ktw1525/KiCAD_Libraries/3D/JB-601.step

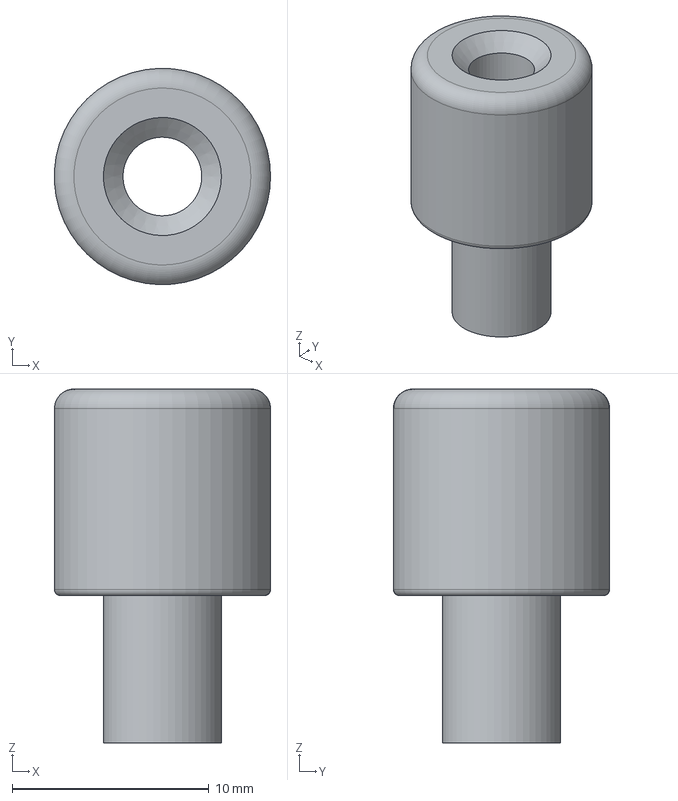
[picture p1: CAD file, 2025-05-28]
3D/JB-601.step
11.0 x 11.0 x 18.0 mm
