ktw1525/KiCAD_Libraries/3D/push button.FCStd

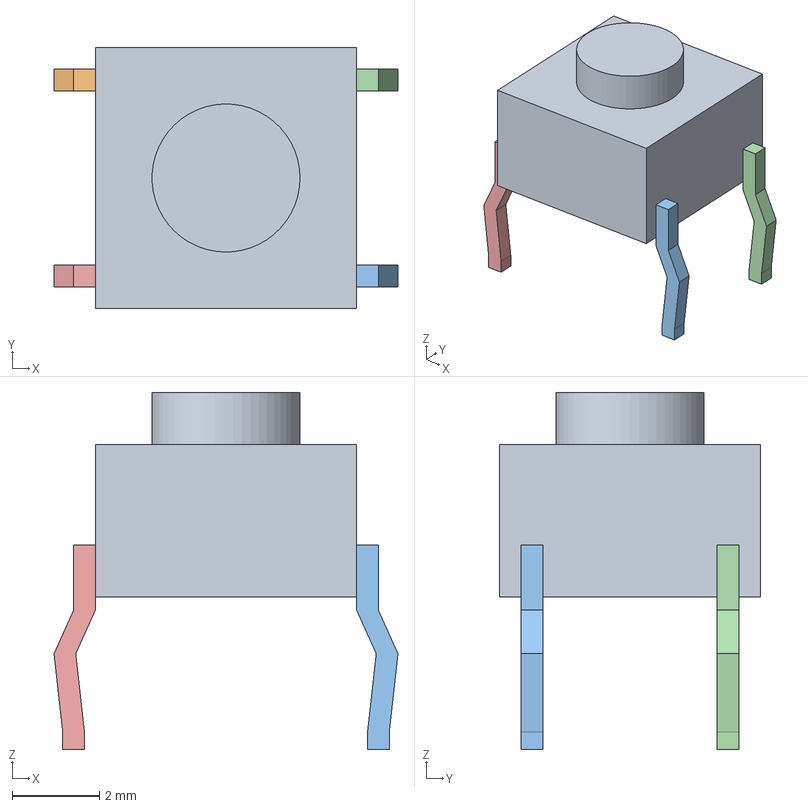
[picture p2: CAD file, 2025-05-28]
3D/push button.FCStd
7.90 x 6.00 x 8.20 mm
몸통
foot
foot (Mirror #3)
foot (Mirror #1)
foot (Mirror #2)
