ktw1525/KiCAD_Libraries/3D/YDSR-4036KM.step

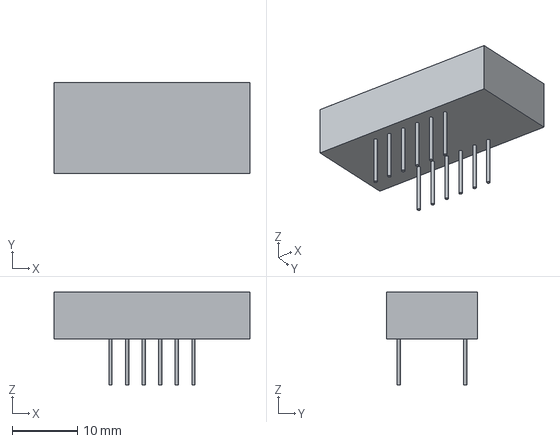
[picture p3: CAD file, 2025-05-28]
3D/YDSR-4036KM.step
30.0 x 14.0 x 14.2 mm
