ktw1525/KiCAD_Libraries/3D/TS-1105-4.3MM.step

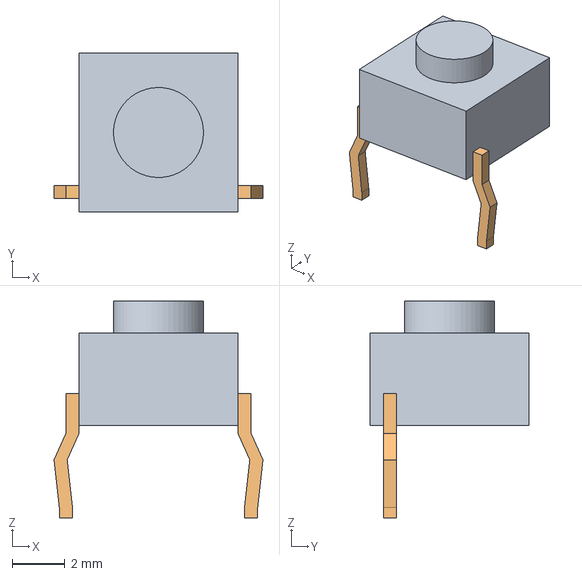
[picture p4: CAD file, 2025-05-28]
3D/TS-1105-4.3MM.step
7.90 x 6.00 x 8.20 mm
