ktw1525/KiCAD_Libraries/3D/br-112.step

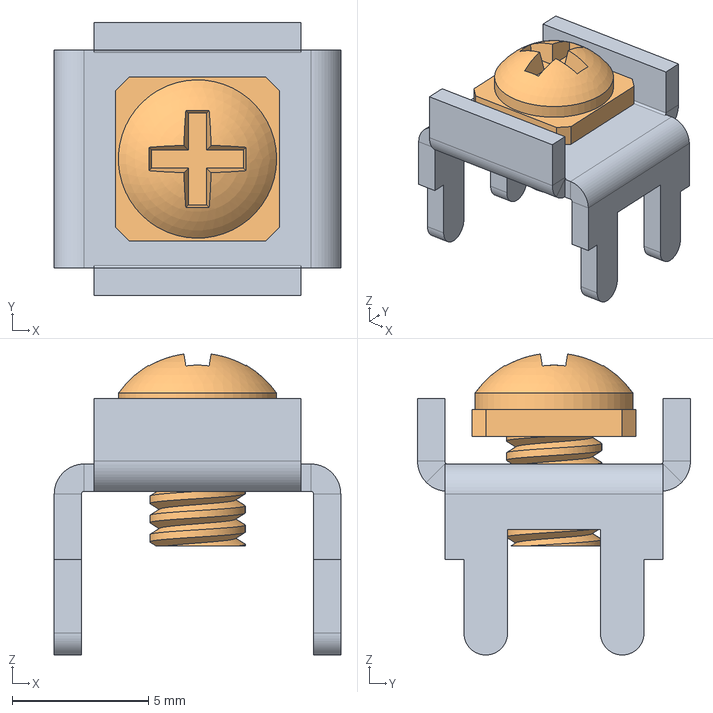
[picture p5: CAD file, 2025-01-15]
3D/br-112.step
10.5 x 10.0 x 11.0 mm
M3.5_SQPAD
