ktw1525/KiCAD_Libraries/3D/br-114.step

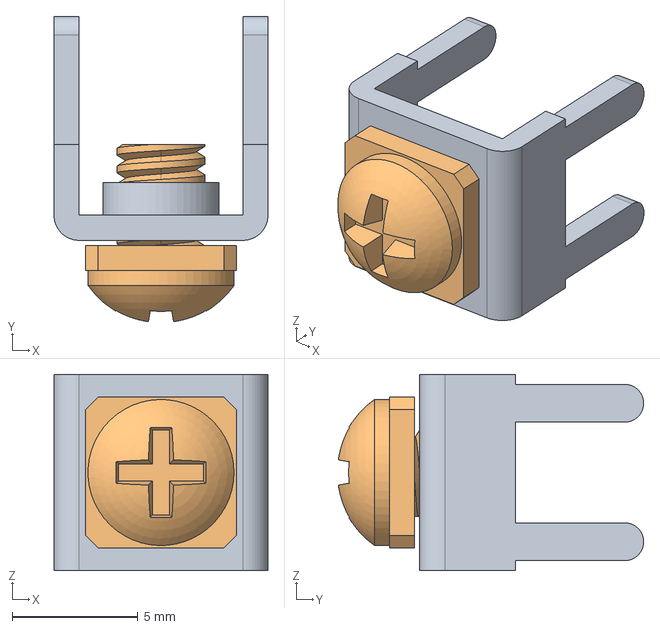
[picture p6: CAD file, 2025-01-15]
3D/br-114.step
8.50 x 12.1 x 7.80 mm
BR-114
M3.5_SQPAD
