ktw1525/KiCAD_Libraries/3D/WM-N502K.step

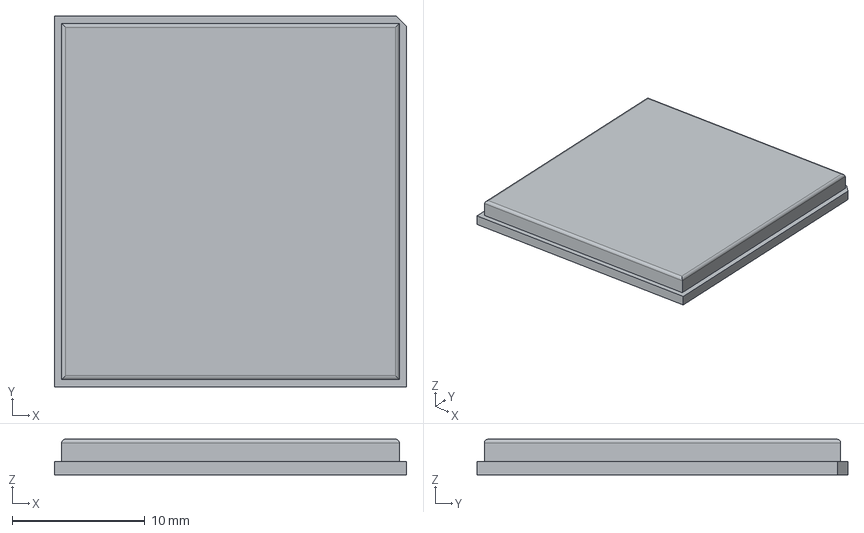
[picture p7: CAD file, 2025-01-07]
3D/WM-N502K.step
26.6 x 28.0 x 2.70 mm
