ktw1525/KiCAD_Libraries/3D/IRM-15-5.stp

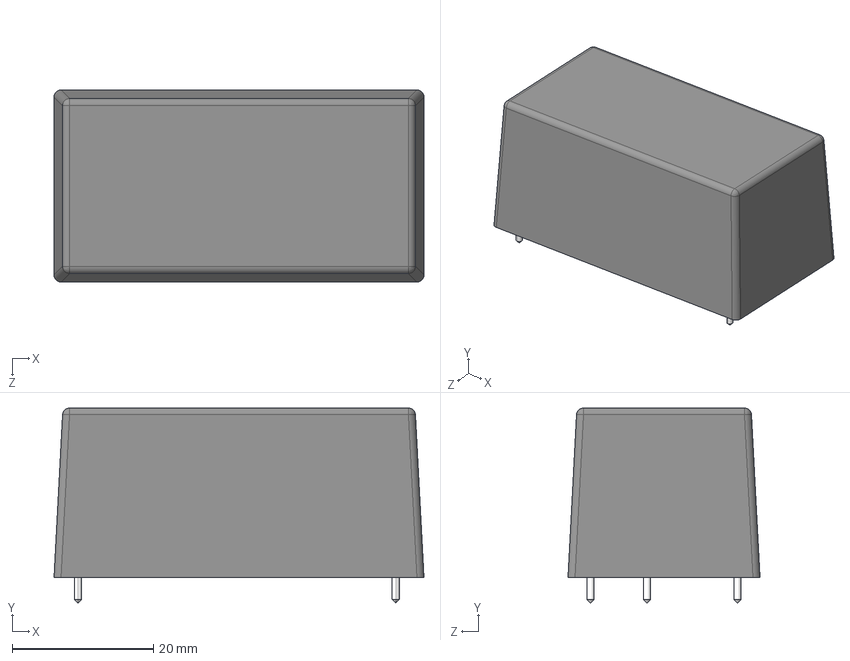
[picture p8: CAD file, 2025-01-02]
3D/IRM-15-5.stp
52.4 x 27.6 x 27.2 mm
