ktw1525/KiCAD_Libraries/3D/7701.stp

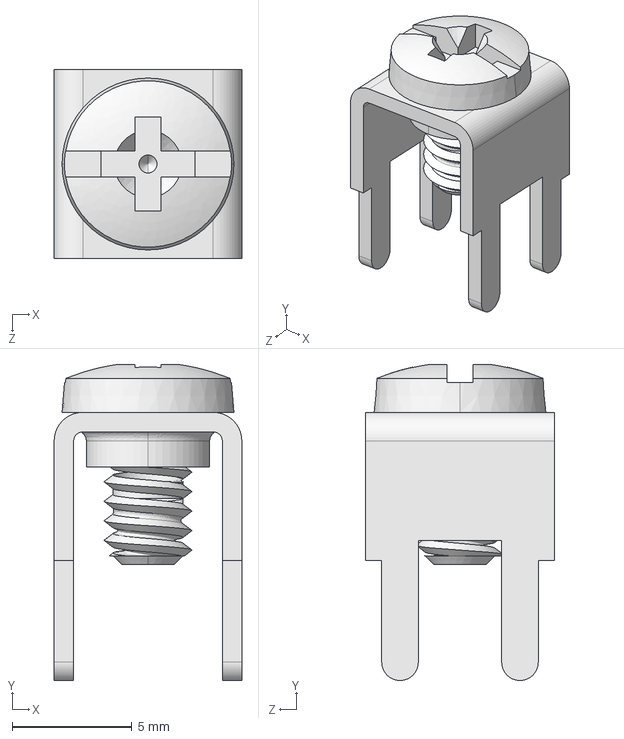
[picture p9: CAD file, 2025-01-02]
3D/7701.stp
7.82 x 13.2 x 7.87 mm
