ktw1525/KiCAD_Libraries/3D/HLK-10M05.stp

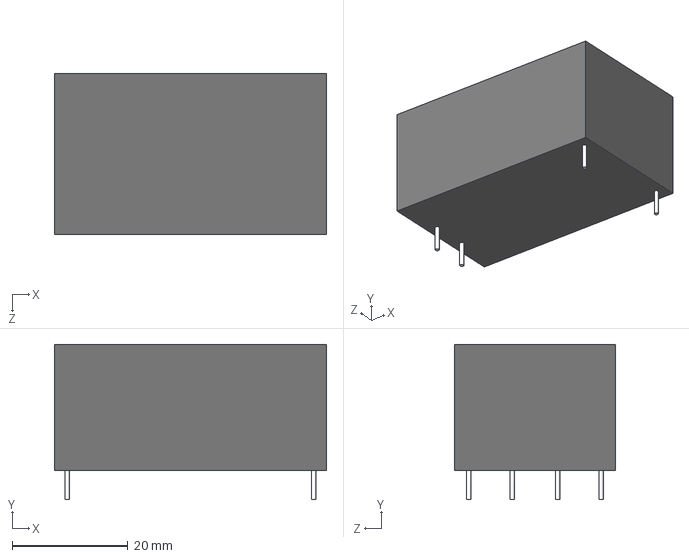
[picture p10: CAD file, 2025-01-02]
3D/HLK-10M05.stp
46.9 x 26.8 x 27.8 mm
