ktw1525/KiCAD_Libraries/3D/BG95-M3.stp

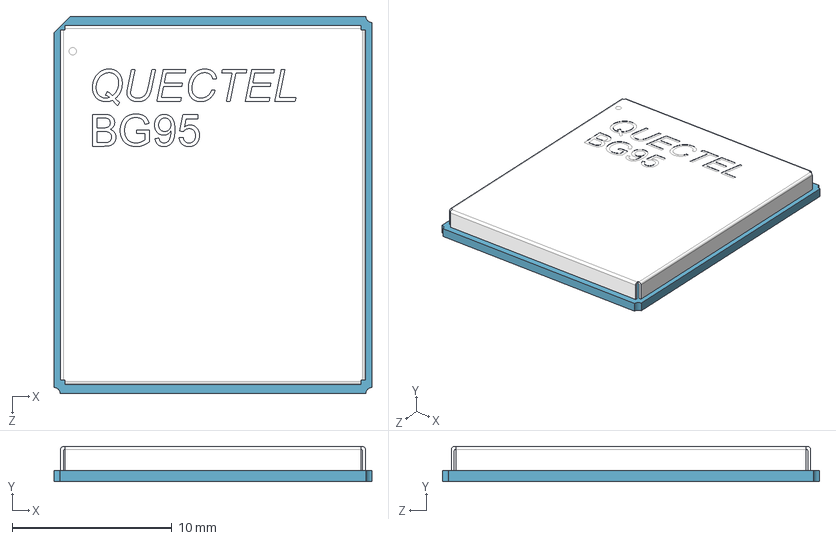
[picture p11: CAD file, 2024-12-19]
3D/BG95-M3.stp
19.9 x 2.20 x 23.6 mm
