ktw1525/KiCAD_Libraries/3D/W5100S-L.stp

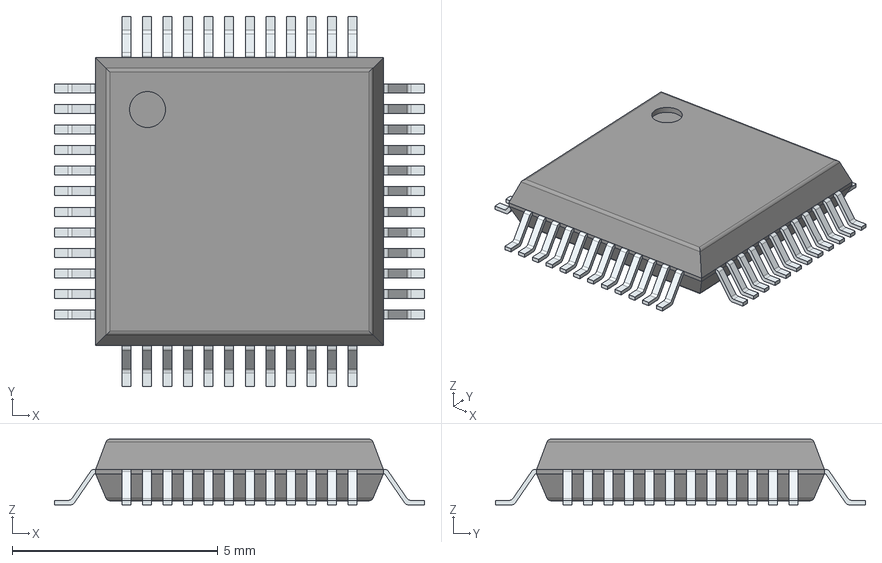
[picture p12: CAD file, 2024-12-19]
3D/W5100S-L.stp
9.00 x 9.00 x 1.60 mm
PinsArrayLR
PinsArrayTB
