ktw1525/KiCAD_Libraries/3D/RAPC712BK.stp

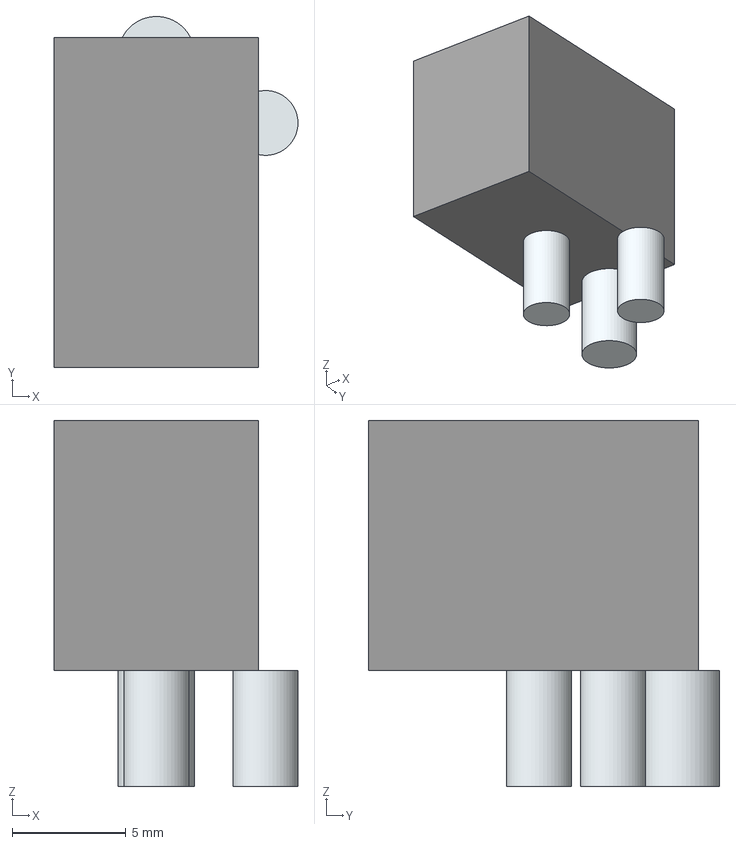
[picture p13: CAD file, 2024-12-13]
3D/RAPC712BK.stp
10.7 x 15.4 x 16.1 mm
Leads
