ktw1525/KiCAD_Libraries/3D/PJ-037AH.stp

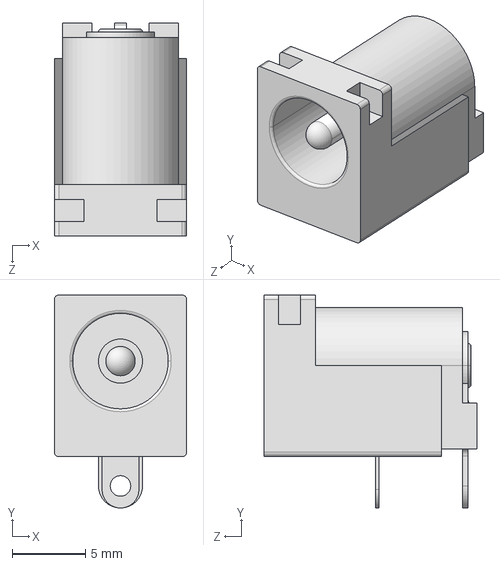
[picture p14: CAD file, 2024-12-13]
3D/PJ-037AH.stp
9.00 x 14.5 x 14.5 mm
