ktw1525/KiCAD_Libraries/3D/TL3302AF260QG.stp

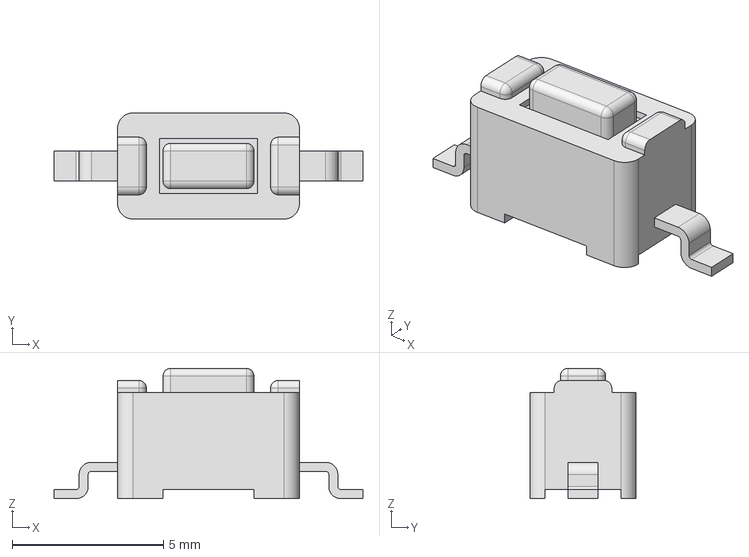
[picture p15: CAD file, 2024-12-11]
3D/TL3302AF260QG.stp
10.2 x 3.50 x 4.30 mm
