ktw1525/KiCAD_Libraries/3D/PTD901-1015F-A203.stp

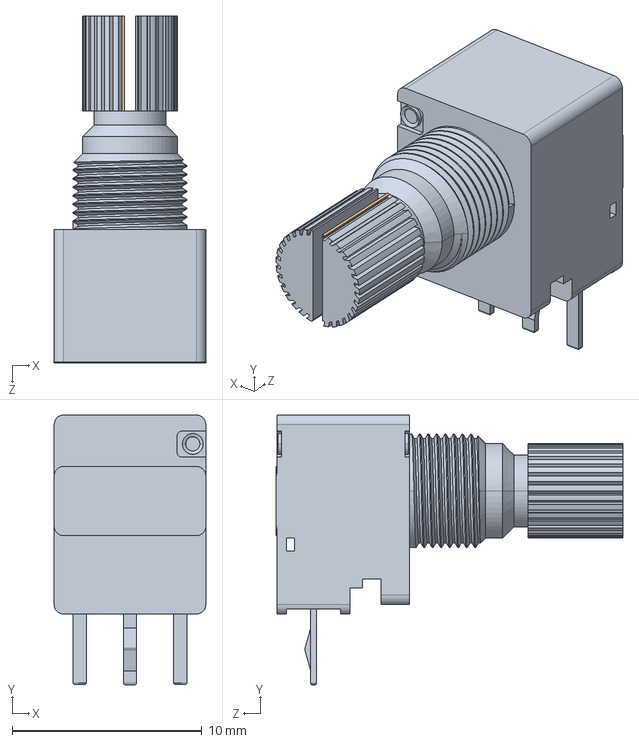
[picture p16: CAD file, 2024-12-11]
3D/PTD901-1015F-A203.stp
8.00 x 14.2 x 18.3 mm
