ktw1525/KiCAD_Libraries/3D/PTD902-2015K-C504.stp

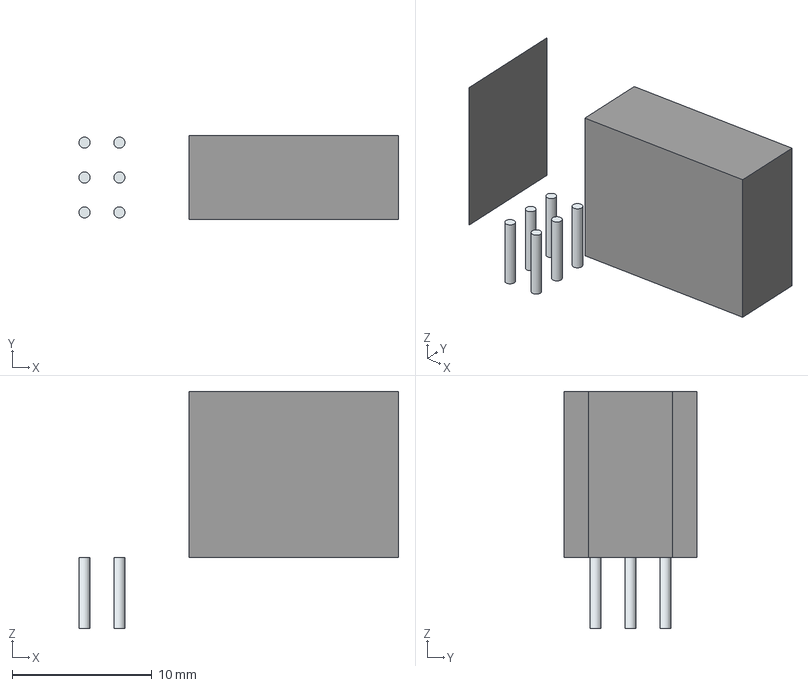
[picture p17: CAD file, 2024-12-11]
3D/PTD902-2015K-C504.stp
24.6 x 9.50 x 17.0 mm
Leads
