ktw1525/KiCAD_Libraries/3D/PTD902-2015F-A103.stp

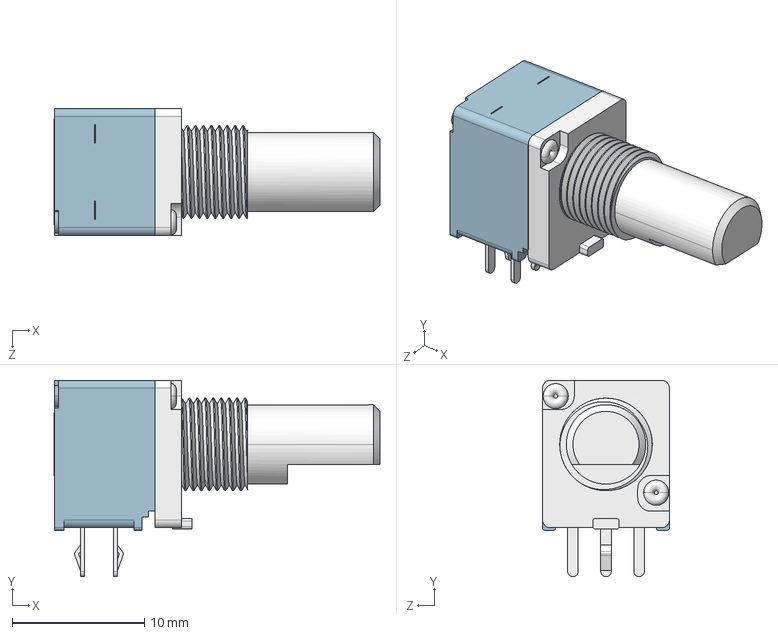
[picture p18: CAD file, 2024-12-11]
3D/PTD902-2015F-A103.stp
24.7 x 14.9 x 9.60 mm
