ktw1525/KiCAD_Libraries/3D/LD1085D2T33R.stp

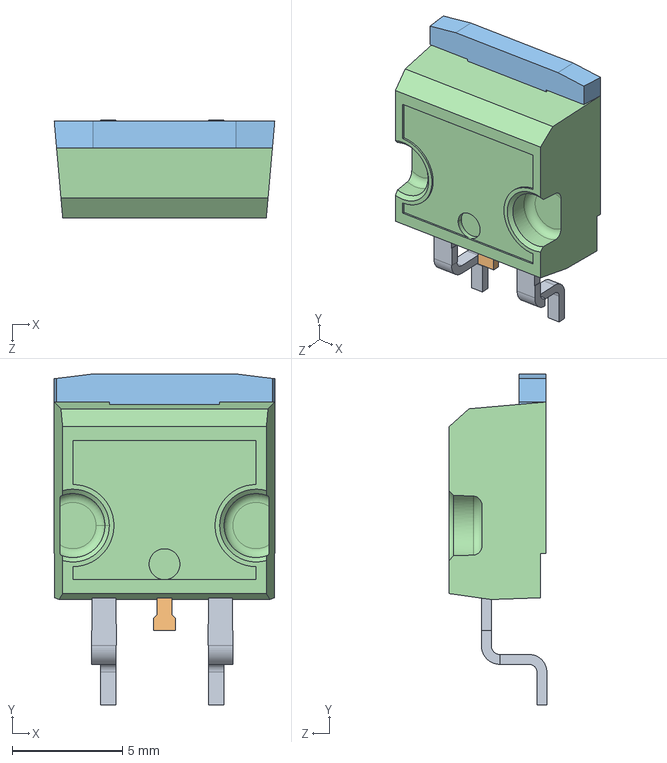
[picture p19: CAD file, 2024-12-09]
3D/LD1085D2T33R.stp
10.0 x 15.0 x 4.43 mm
