ktw1525/KiCAD_Libraries/3D/LM1085ISX-ADJ_NOPB.stp

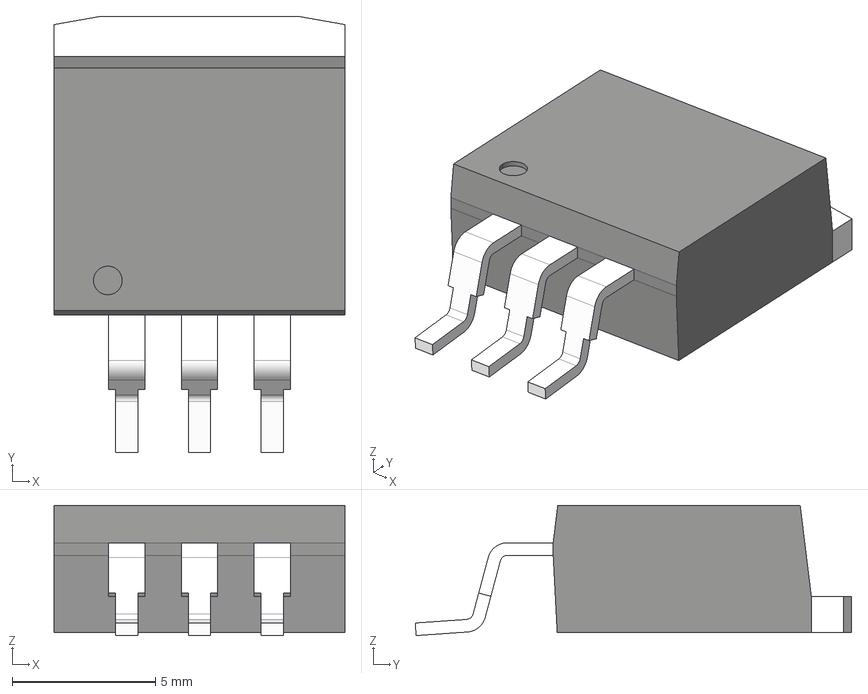
[picture p20: CAD file, 2024-12-04]
3D/LM1085ISX-ADJ_NOPB.stp
10.2 x 15.2 x 4.54 mm
BODY-TO
HTSINK-TO263
LEAD-TO263 x 3
