ktw1525/KiCAD_Libraries/3D/BAT54S.stp

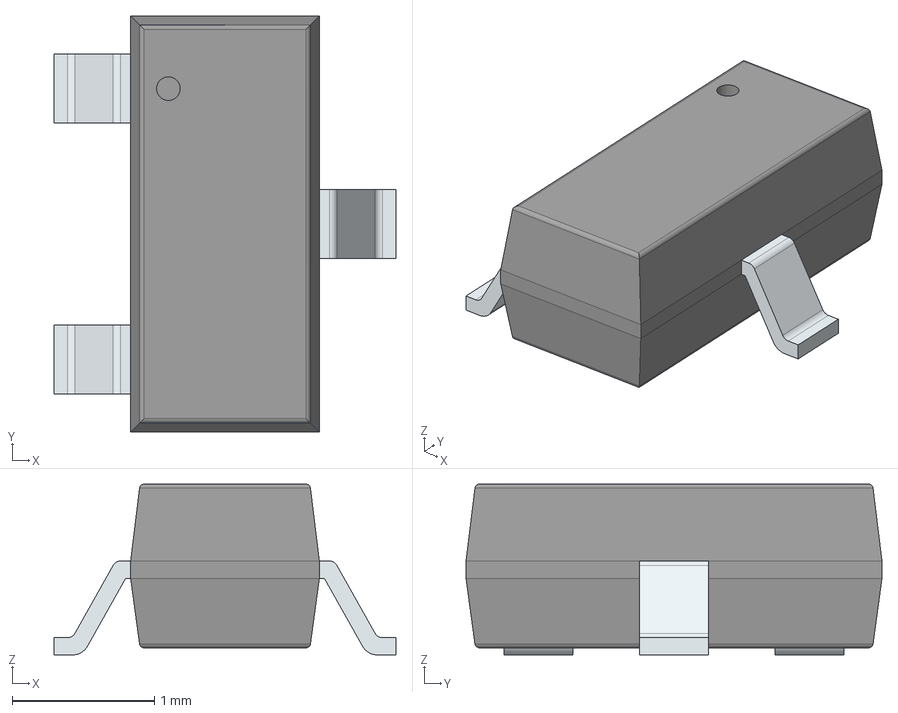
[picture p21: CAD file, 2024-12-04]
3D/BAT54S.stp
2.40 x 2.92 x 1.20 mm
PinsArrayL
FilletPinR
