ktw1525/KiCAD_Libraries/3D/ST1L05CPU33R.stp

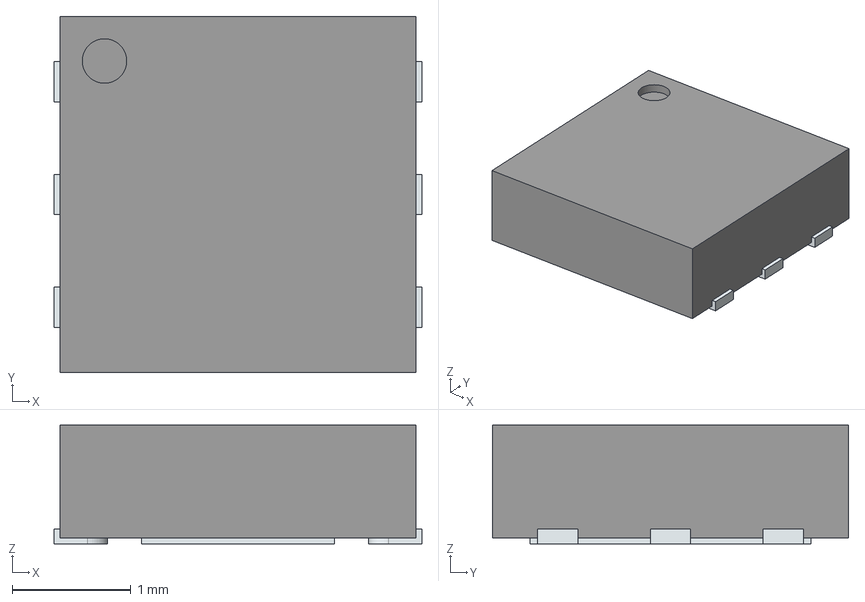
[picture p22: CAD file, 2024-12-03]
3D/ST1L05CPU33R.stp
3.10 x 3.00 x 1.00 mm
ThermalPin
PinsArrayLR
