ktw1525/KiCAD_Libraries/3D/OPA567AIRHGR.stp

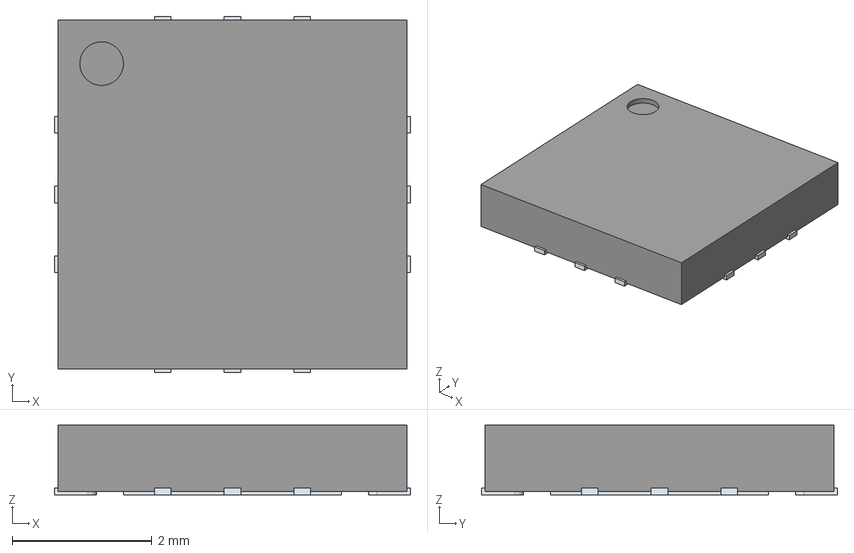
[picture p23: CAD file, 2024-12-03]
3D/OPA567AIRHGR.stp
5.10 x 5.10 x 1.00 mm
ThermalPin
PinsArrayLR
PinsArrayTB
