ktw1525/KiCAD_Libraries/3D/GSB1C41110SSHR.stp

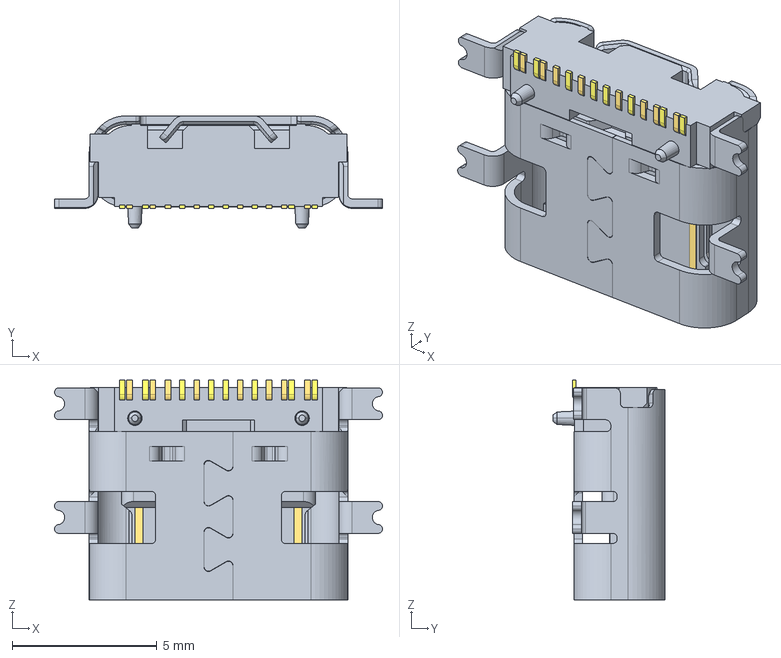
[picture p24: CAD file, 2024-12-03]
3D/GSB1C41110SSHR.stp
11.3 x 3.89 x 7.60 mm
