ktw1525/KiCAD_Libraries/3D/STM32G051F8P6.stp

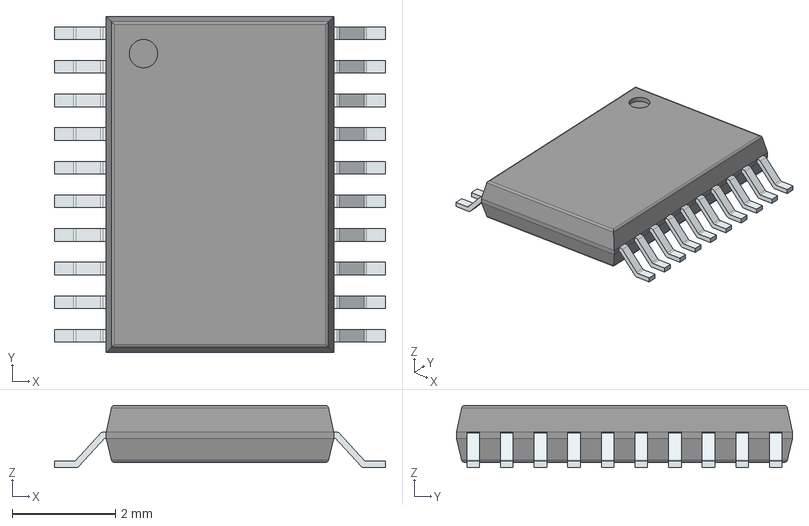
[picture p25: CAD file, 2024-12-03]
3D/STM32G051F8P6.stp
6.40 x 6.50 x 1.20 mm
PinsArrayLR
