ktw1525/KiCAD_Libraries/3D/CP2102N-A02-GQFN20.stp

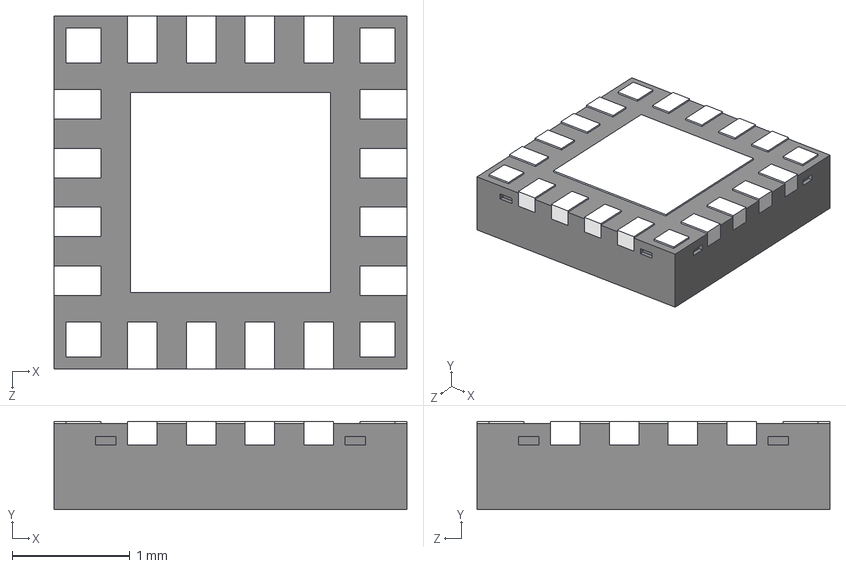
[picture p26: CAD file, 2024-12-03]
3D/CP2102N-A02-GQFN20.stp
3.00 x 0.75 x 3.00 mm
