ktw1525/KiCAD_Libraries/3D/STM32L011F4U6TR.stp

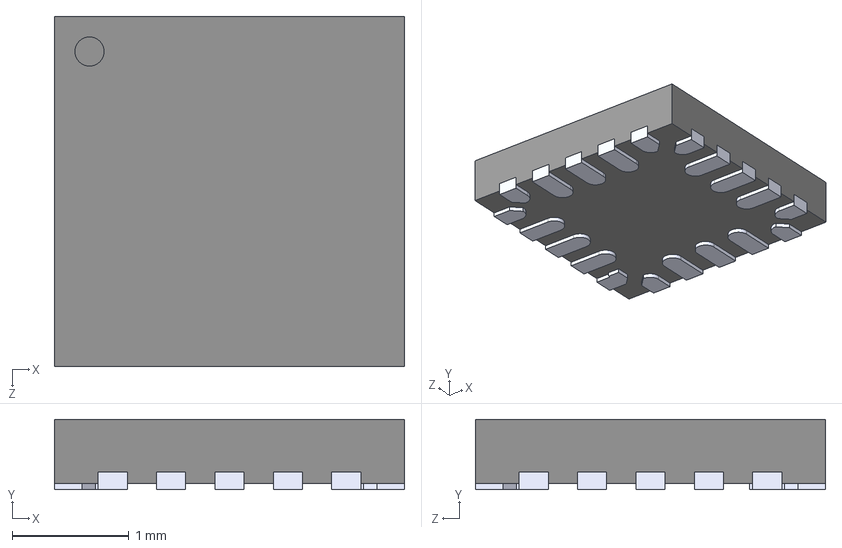
[picture p27: CAD file, 2024-12-03]
3D/STM32L011F4U6TR.stp
3.00 x 0.6 x 3.00 mm
STM8L151F3U6TR_16
STM8L151F3U6TR_6
STM8L151F3U6TR_20
STM8L151F3U6TR_12
STM8L151F3U6TR_5
STM8L151F3U6TR_1
STM8L151F3U6TR_7
STM8L151F3U6TR_3
STM8L151F3U6TR_9
STM8L151F3U6TR_4
STM8L151F3U6TR_10
STM8L151F3U6TR_11
STM8L151F3U6TR_13
STM8L151F3U6TR_19
STM8L151F3U6TR_18
STM8L151F3U6TR_15
STM8L151F3U6TR_8
STM8L151F3U6TR
STM8L151F3U6TR_17
STM8L151F3U6TR_14
STM8L151F3U6TR_2
