ktw1525/KiCAD_Libraries/3D/MFM-05-5.stp

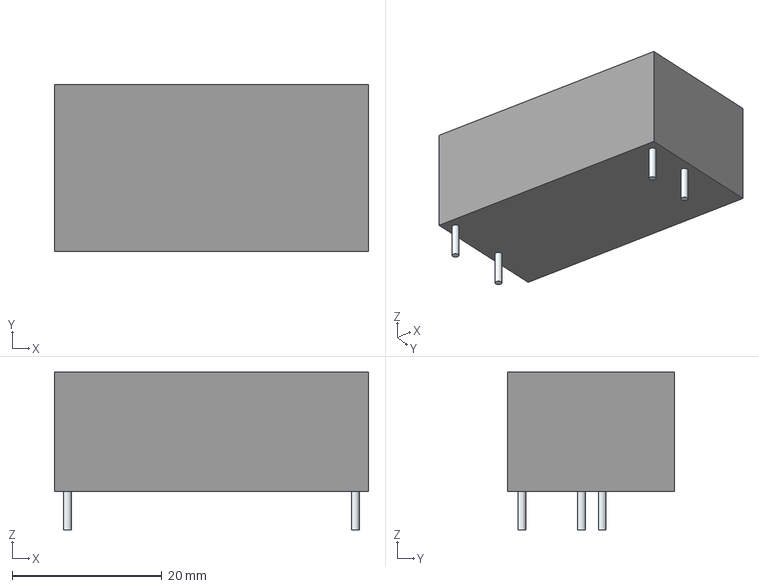
[picture p28: CAD file, 2024-12-03]
3D/MFM-05-5.stp
42.0 x 22.3 x 21.1 mm
Leads x 4
