ktw1525/KiCAD_Libraries/3D/ZMPT101B.stp

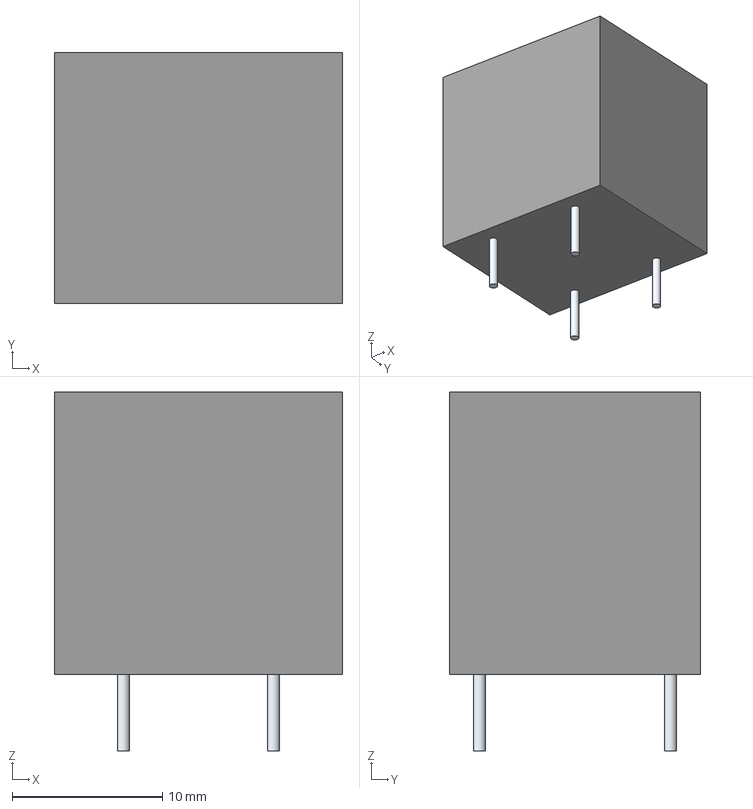
[picture p29: CAD file, 2024-12-03]
3D/ZMPT101B.stp
19.2 x 16.7 x 23.9 mm
Leads x 4
