ktw1525/KiCAD_Libraries/3D/HLK-15M05C.stp

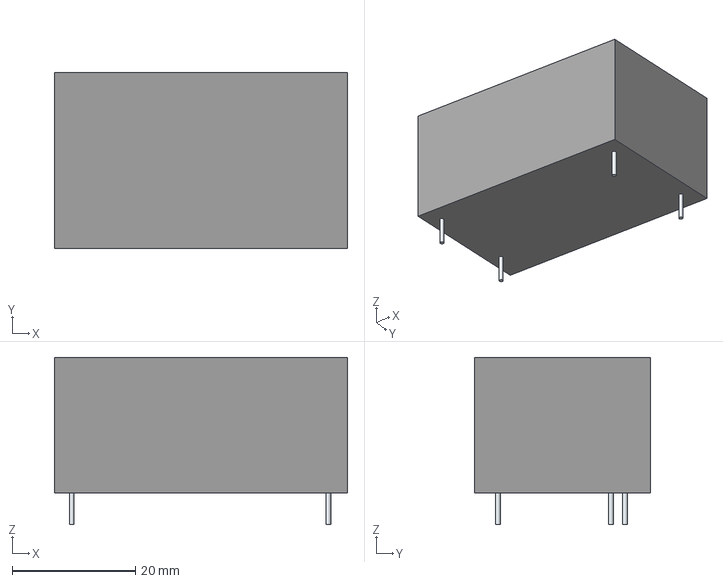
[picture p30: CAD file, 2024-12-03]
3D/HLK-15M05C.stp
47.5 x 28.5 x 27.1 mm
Leads
