ktw1525/KiCAD_Libraries/3D/ADA4528-2ACPZ-R7.stp

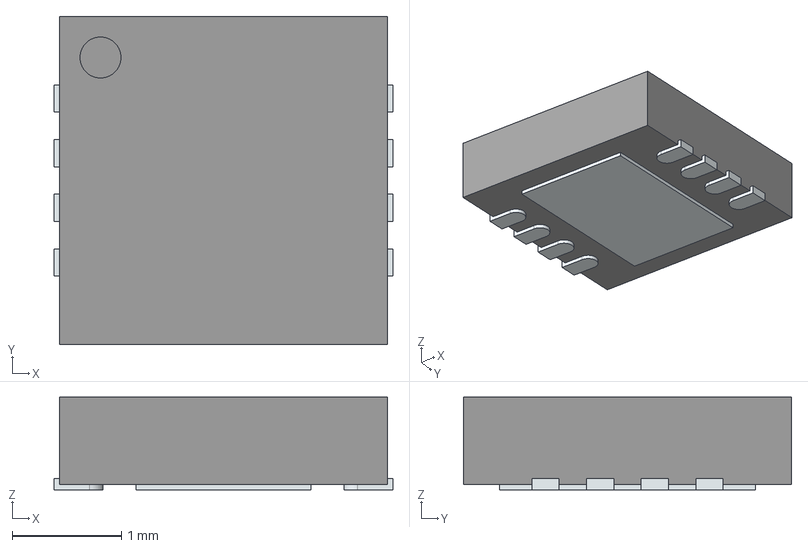
[picture p31: CAD file, 2024-12-03]
3D/ADA4528-2ACPZ-R7.stp
3.10 x 3.00 x 0.85 mm
ThermalPin
PinsArrayLR
