ktw1525/KiCAD_Libraries/3D/NTC10D-11.stp

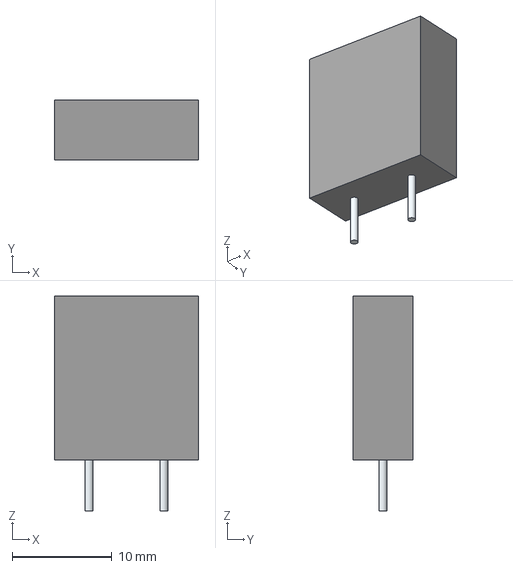
[picture p32: CAD file, 2024-12-03]
3D/NTC10D-11.stp
14.5 x 6.00 x 21.6 mm
Leads
