ktw1525/KiCAD_Libraries/3D/SSHB10HS-R11100.stp

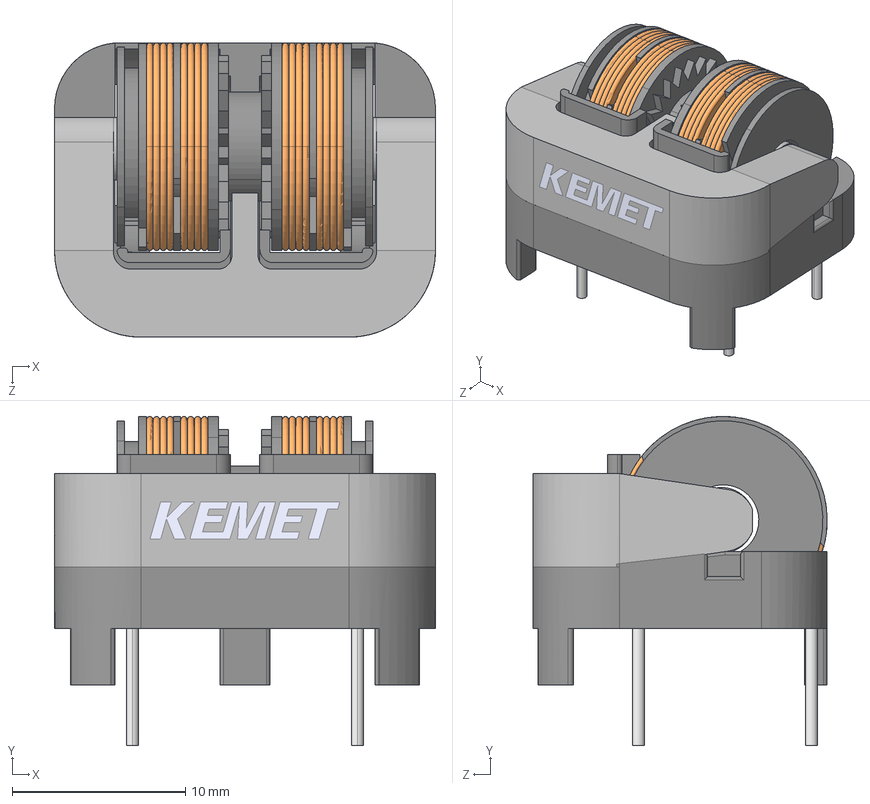
[picture p33: CAD file, 2024-12-03]
3D/SSHB10HS-R11100.stp
22.0 x 19.0 x 17.0 mm
