ktw1525/KiCAD_Libraries/3D/CBC3225T470KR.stp

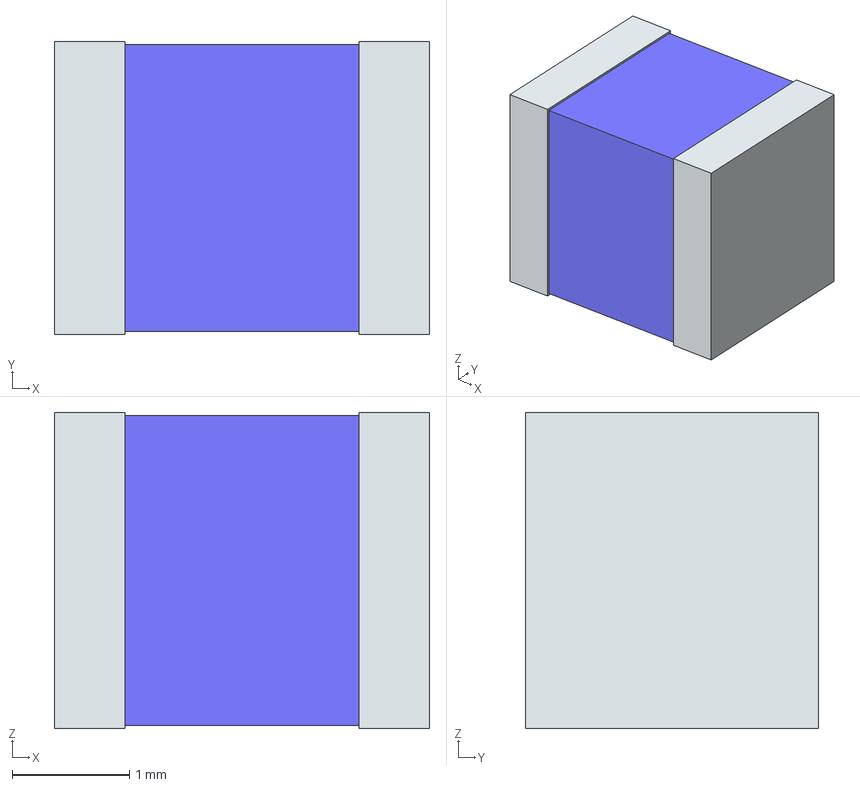
[picture p34: CAD file, 2024-12-03]
3D/CBC3225T470KR.stp
3.20 x 2.50 x 2.70 mm
term1
term2
