ktw1525/KiCAD_Libraries/3D/R76UI21205050J.stp

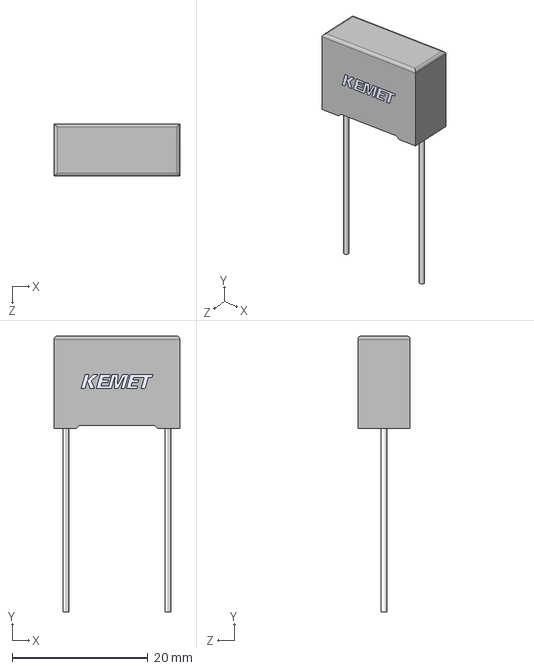
[picture p35: CAD file, 2024-12-03]
3D/R76UI21205050J.stp
18.5 x 40.6 x 7.71 mm
