ktw1525/KiCAD_Libraries/3D/CST206-1A.stp

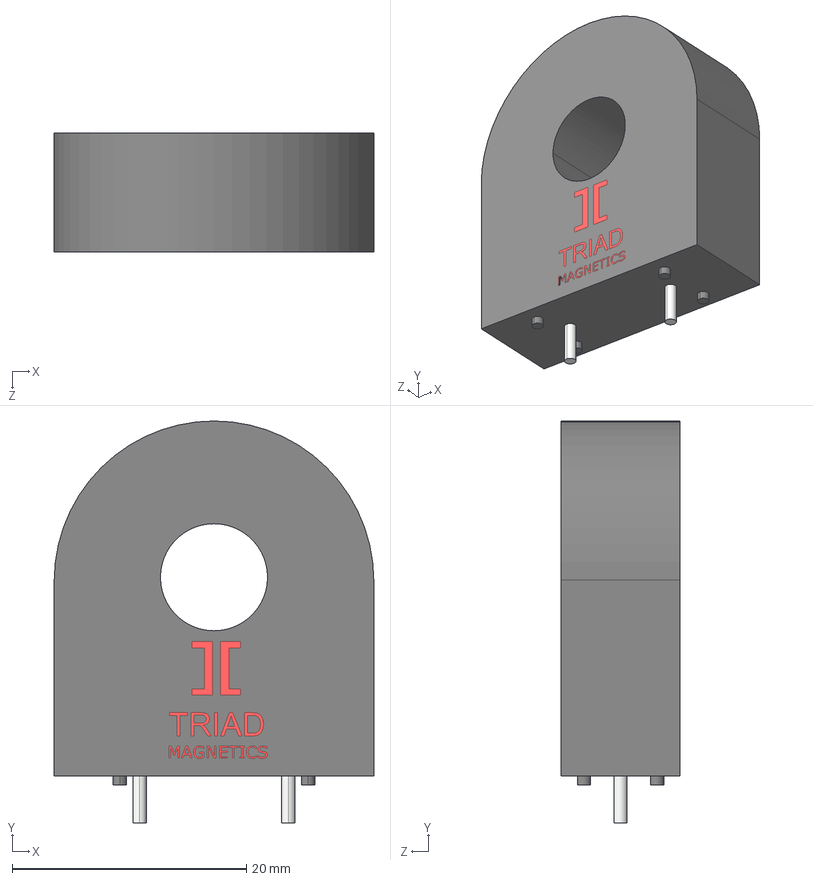
[picture p36: CAD file, 2024-12-03]
3D/CST206-1A.stp
27.3 x 34.3 x 10.2 mm
