ktw1525/KiCAD_Libraries/3D/MOV-10D391K.stp

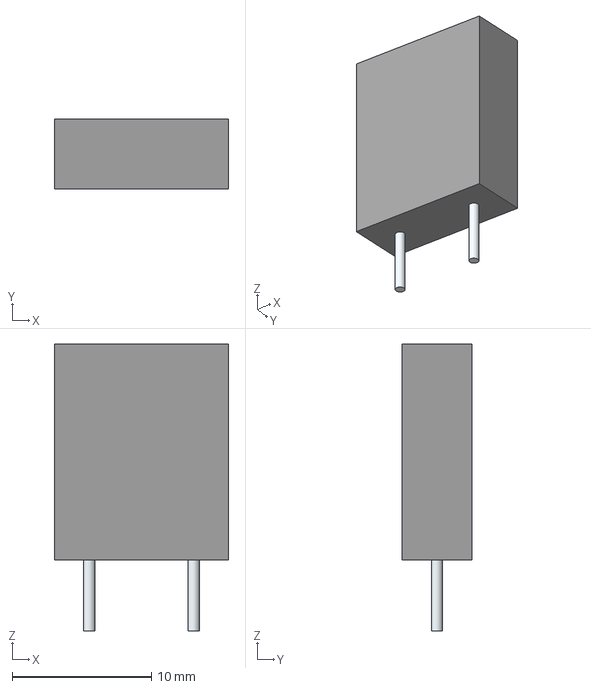
[picture p37: CAD file, 2024-12-03]
3D/MOV-10D391K.stp
12.5 x 5.00 x 20.6 mm
Leads
