ktw1525/KiCAD_Libraries/(list of files, cad)

Other CAD files:
3D/stm32f103c8t6.stp
3D/OPA567AIRHGT.stp
3D/1054500101.stp
3D/12401832E402A.stp
3D/1989447.stp
3D/53375-0410.stp
3D/744770218.stp
3D/B32922X2104K000.stp
3D/LD39200DPUR.stp
3D/MBB02070C1004FCT00.stp
3D/REF35160QDBVR.stp
3D/TPS75833KC.stp
