ktw1525/KiCAD_Libraries/(commit log)

2024-12-03 불필요 파일 제거
2024-12-03 parts updated
    [LD39200DPUR.stp, OPA567AIRHGR.stp, ST1L05CPU33R.stp]
2024-12-04 라이브러리 정리
    [BAT54S.stp, LM1085ISX-ADJ_NOPB.stp, MBB02070C1004FCT00.stp, MMBT3906-TP.stp, MMBT4401-TP.stp, STM32G051F8P6.stp, TPS75833KC.stp]
2024-12-09 components added
    [1054500101.stp, LD1085D2T33R.stp]
2024-12-09 CASE updated
    [744770218.stp]
2024-12-11 parts added
    [OPA388IDBVR.stp, PTD901-1015F-A203.stp, PTD902-2015F-A103.stp, PTD902-2015K-C504.stp]
2024-12-13 1차 마감
    [PJ-037AH.stp, RAPC712BK.stp]
2025-01-15 added parts
    [br-112.step, br-114.step]
